DavidMihic/micromouse/hardware/extras/Micromouse_Footprint.DXF

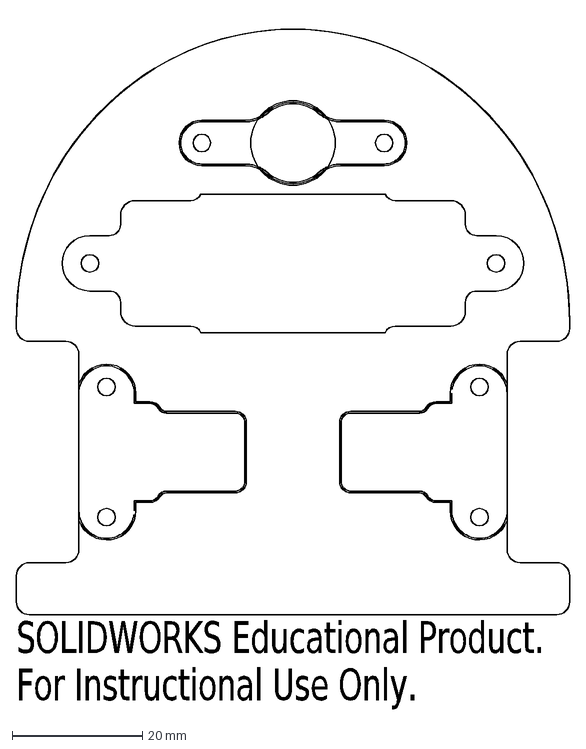
[picture p1: CAD file, 2026-04-24]
hardware/extras/Micromouse_Footprint.DXF
SOLIDWORKS Educational Product.
For Instructional Use Only.
