DavidMihic/micromouse/hardware/motors and wheels/pololu-ball-caster-with-0-375in-ball.SLDPRT

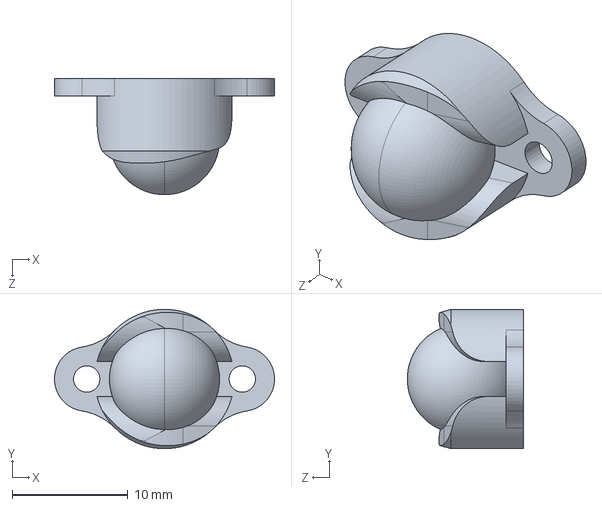
[picture p2: CAD file, 2026-04-17]
hardware/motors and wheels/pololu-ball-caster-with-0-375in-ball.SLDPRT
19.0 x 12.1 x 10.1 mm
