DavidMihic/micromouse/hardware/stl/motor_spacer.STL

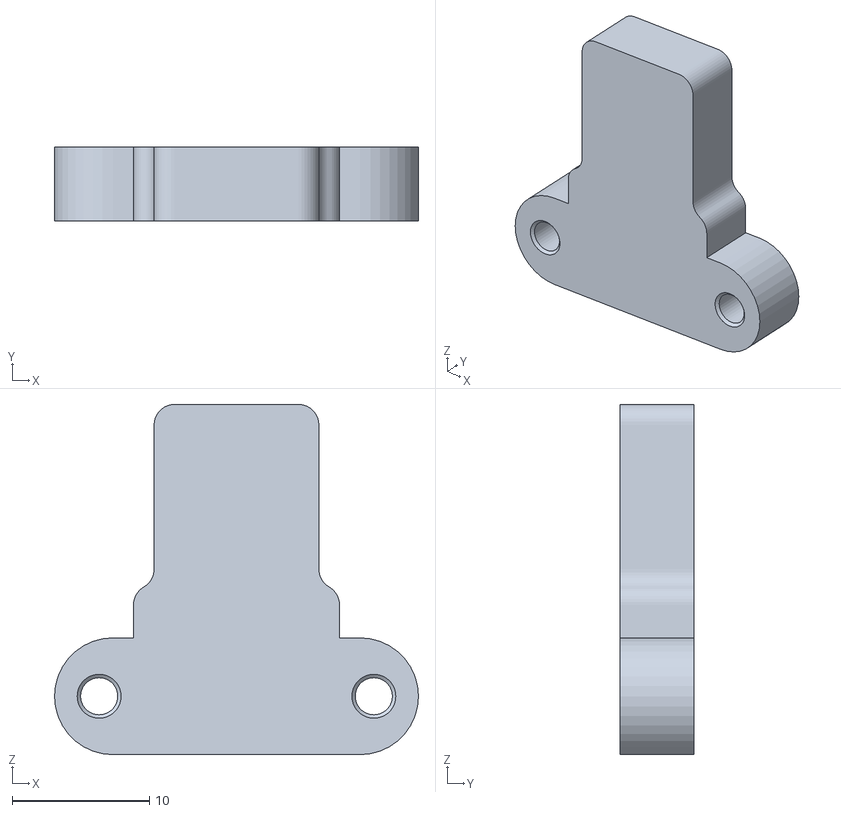
[picture p3: CAD file, 2026-04-29]
hardware/stl/motor_spacer.STL
26.5 x 5.40 x 25.5
