DavidMihic/micromouse/hardware/Visualisation assembly/Micromouse_PCB.step

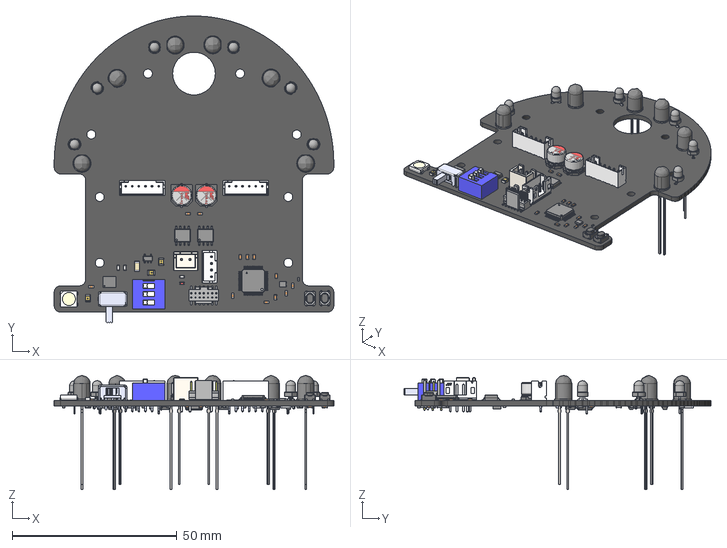
[picture p4: CAD file, 2026-05-03]
hardware/Visualisation assembly/Micromouse_PCB.step
85.0 x 93.3 x 34.7 mm
