DavidMihic/micromouse/pcb/bottom stencil/bottom_stencil.SLDPRT

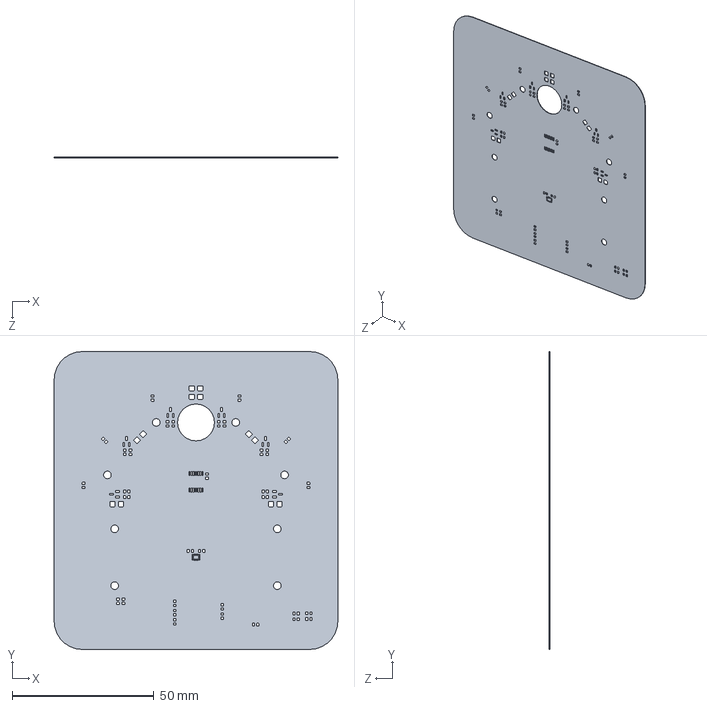
[picture p5: CAD file, 2026-05-12]
pcb/bottom stencil/bottom_stencil.SLDPRT
100.0 x 105.0 x 0.2 mm
