DavidMihic/micromouse/hardware/battery_holder.SLDPRT

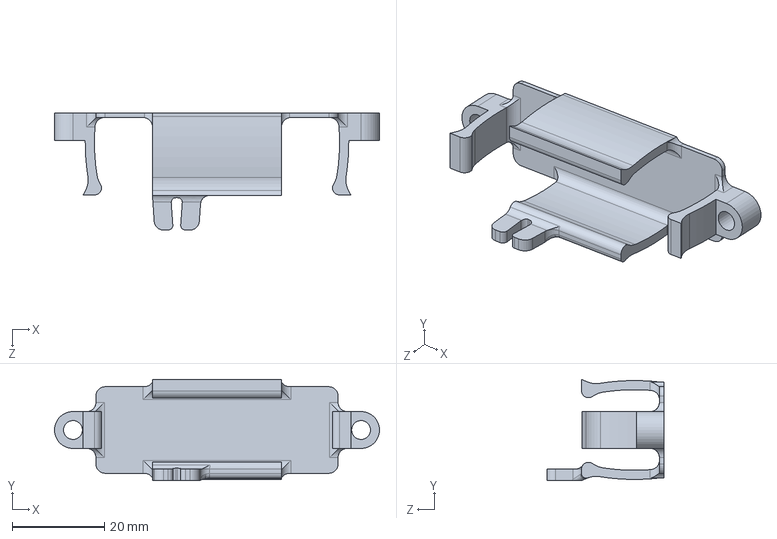
[picture p6: CAD file, 2026-04-29]
hardware/battery_holder.SLDPRT
70.5 x 22.0 x 25.4 mm
