DavidMihic/micromouse/hardware/extras/crta-logo.dxf

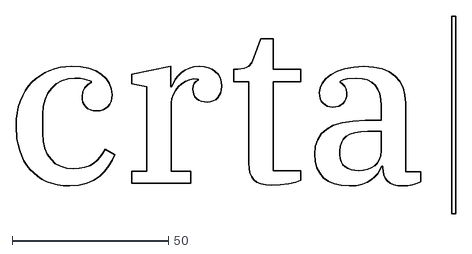
[picture p7: CAD file, 2026-04-23]
hardware/extras/crta-logo.dxf
140.7 x 63.1
