DavidMihic/micromouse/hardware/stl/bracket.STL

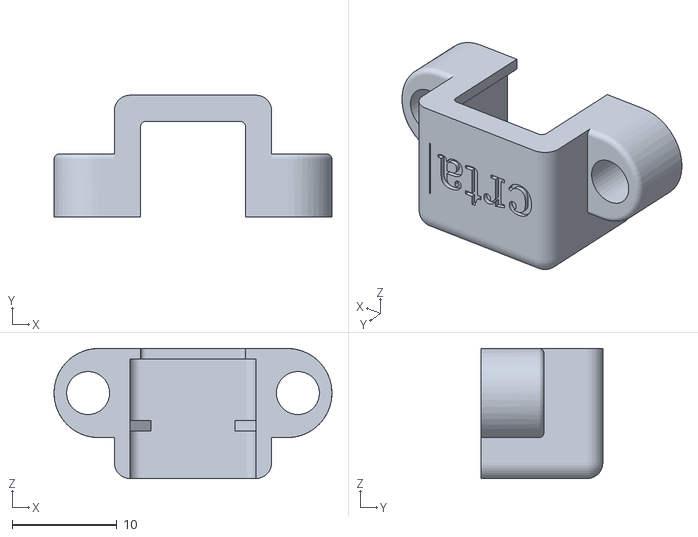
[picture p8: CAD file, 2026-04-23]
hardware/stl/bracket.STL
26.5 x 11.6 x 12.4
