DavidMihic/micromouse/hardware/PCB_concept.SLDPRT

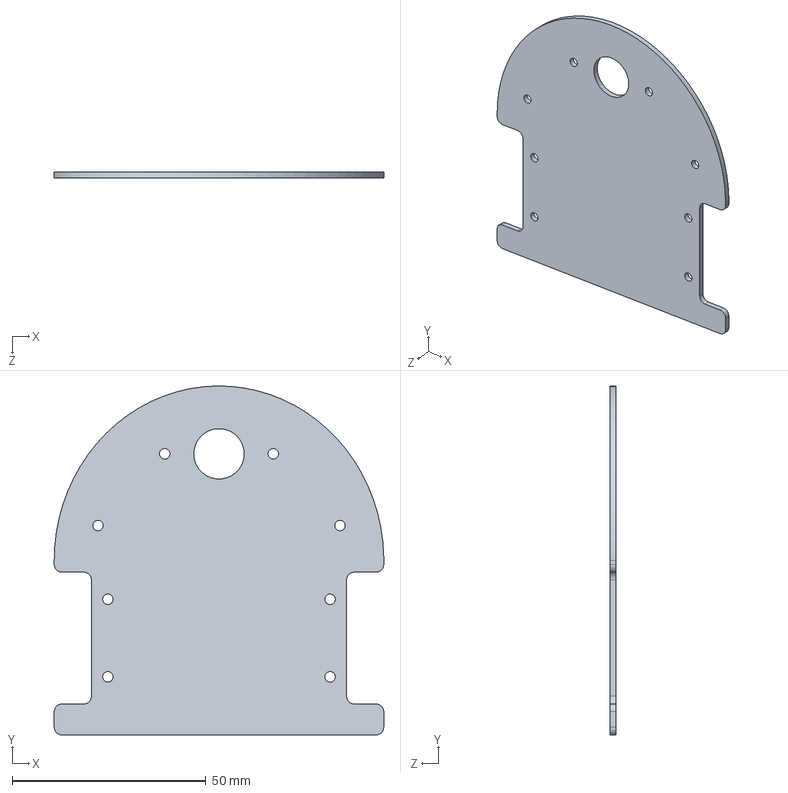
[picture p9: CAD file, 2026-04-23]
hardware/PCB_concept.SLDPRT
85.0 x 90.0 x 1.60 mm
