DavidMihic/micromouse/hardware/stl/caster_spacer.STL

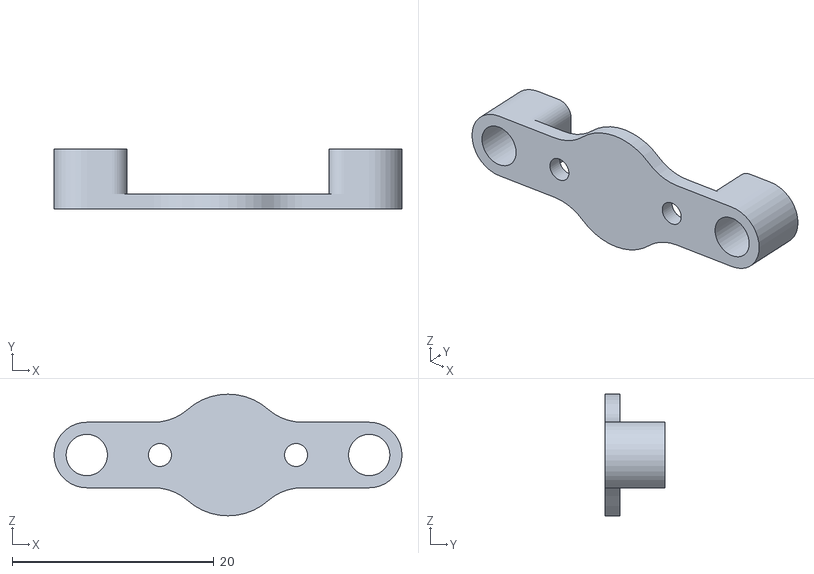
[picture p10: CAD file, 2026-04-23]
hardware/stl/caster_spacer.STL
34.5 x 5.97 x 12.1
