DavidMihic/micromouse/hardware/battery.SLDPRT

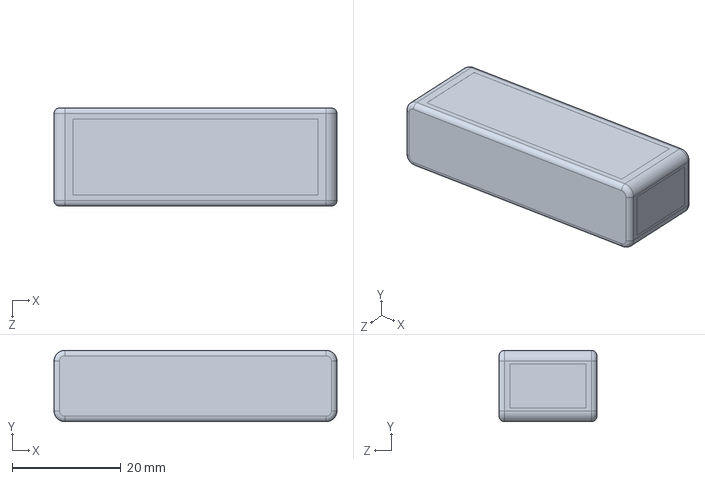
[picture p11: CAD file, 2026-04-17]
hardware/battery.SLDPRT
52.0 x 13.1 x 18.0 mm
