DavidMihic/micromouse/hardware/brackets and screws/fasteners/din912-m2.5x13.SLDPRT

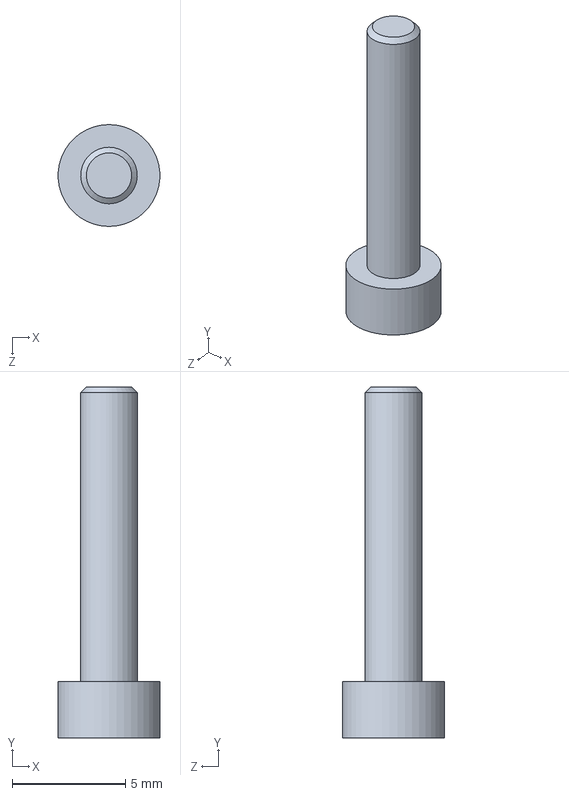
[picture p12: CAD file, 2026-04-19]
hardware/brackets and screws/fasteners/din912-m2.5x13.SLDPRT
4.49 x 15.5 x 4.50 mm
