DavidMihic/micromouse/hardware/brackets and screws/front_cover.SLDPRT

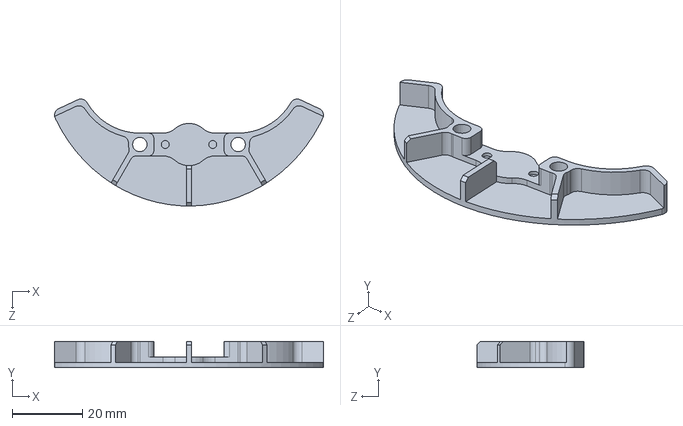
[picture p13: CAD file, 2026-05-25]
hardware/brackets and screws/front_cover.SLDPRT
76.5 x 7.47 x 30.4 mm
