DavidMihic/micromouse/hardware/motors and wheels/MotorEncoderWheel.SLDASM

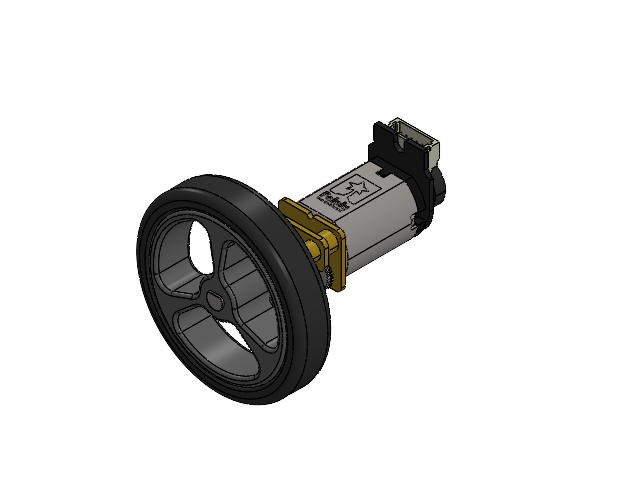
[picture p15: CAD file, 2026-04-17]
hardware/motors and wheels/MotorEncoderWheel.SLDASM
mmgm-cb-ext-shaft.step
magnetic-encoder-with-side-entry-connector-for-micro-metal-gearmotors.step
magnetic-encoder-disc-for-micro-metal-gearmotors.step
pololu-wheel-32x7mm-black.step
