DavidMihic/micromouse/hardware/Visualisation assembly/Micromouse_Assembly_real.SLDASM

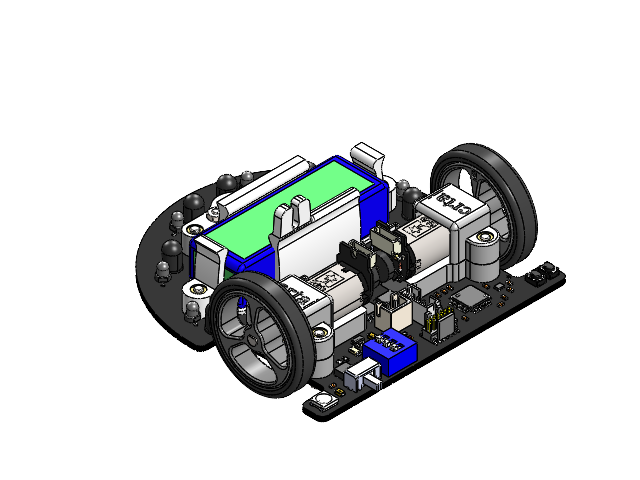
[picture p16: CAD file, 2026-05-03]
hardware/Visualisation assembly/Micromouse_Assembly_real.SLDASM
mmgm-cb-ext-shaft.step x 2
magnetic-encoder-with-side-entry-connector-for-micro-metal-gearmotors.step x 2
magnetic-encoder-disc-for-micro-metal-gearmotors.step x 2
pololu-wheel-32x7mm-black.step x 2
pololu-ball-caster-with-0-375in-ball
bracket x 2
battery
motor_spacer x 2
caster_spacer
battery_holder
M2.5 Insert x 8
din912-m2.5x13 x 4
din912-m2.5x8 x 4
din7380-m2x5 x 2
din934-m2 x 2
Micromouse_PCB
