DavidMihic/micromouse/(list of files, cad)

Other CAD files:
pcb/bottom stencil/bottom solder.DWG
hardware/stl/PCB.STL
hardware/Visualisation assembly/Micromouse_PCB.SLDPRT
hardware/brackets and screws/bracket.SLDPRT
hardware/brackets and screws/caster_spacer.SLDPRT
hardware/brackets and screws/fasteners/M2.5 Insert.SLDPRT
hardware/brackets and screws/fasteners/din7380-m2x5.SLDPRT
hardware/brackets and screws/fasteners/din912-m2.5x8.SLDPRT
hardware/brackets and screws/fasteners/din912-m2x5.SLDPRT
hardware/brackets and screws/fasteners/din934-m2.SLDPRT
hardware/brackets and screws/micro-metal-gearmotor-bracket.SLDPRT
hardware/brackets and screws/motor_spacer.SLDPRT
hardware/stl/battery_holder.STL
