DavidMihic/micromouse/(list of files, drawings)

Other design files:
pcb/Micromouse.PrjPcb
pcb/Micromouse_PCB_Final.PcbDoc
pcb/Schematic-Lib-PhilsLab.SchLib
pcb/Shema.SchDoc
