DavidMihic/micromouse/software/software.ioc

Mcu.UserName=STM32G474CETx
PA0.GPIO_Label=E_A_L
PA0.Signal=S_TIM2_CH1
PA1.GPIO_Label=E_B_L
PA1.Signal=S_TIM2_CH2
PA10.GPIO_Label=IN_1_R
PA10.Signal=S_TIM1_CH3
PA11.GPIO_Label=IN_2_R
PA11.Signal=S_TIM1_CH4
PA12.GPIO_Label=E_B_R
PA12.Signal=S_TIM4_CH2
PA13.Signal=SYS_JTMS-SWDIO
PA14.Signal=SYS_JTCK-SWCLK
PA15.GPIO_Label=LED_IN
PA15.Signal=S_TIM8_CH1
PA2.Signal=USART2_TX
PA3.Signal=USART2_RX
PA4.GPIO_Label=IMU_CS
PA4.Signal=GPIO_Output
PA5.GPIO_Label=IMU_SCK
PA5.Signal=SPI1_SCK
PA6.GPIO_Label=IMU_MISO
PA6.Signal=SPI1_MISO
PA7.GPIO_Label=IMU_MOSI
PA7.Signal=SPI1_MOSI
PA8.GPIO_Label=IN_1_L
PA8.Signal=S_TIM1_CH1
PA9.GPIO_Label=IN_2_L
PA9.Signal=S_TIM1_CH2
PB0.GPIO_Label=IMU_INT2
PB0.Signal=GPXTI0
PB1.GPIO_Label=IR_REC_2
PB1.Signal=ADC1_IN12
PB10.GPIO_Label=DMUX_EN
PB10.Signal=GPIO_Output
PB11.GPIO_Label=IR_REC_3
PB11.Signal=ADC1_IN14
PB12.GPIO_Label=IR_REC_4
PB12.Signal=ADC1_IN11
PB13.GPIO_Label=BTN_2
PB13.Signal=GPXTI13
PB14.GPIO_Label=IR_REC_5
PB14.Signal=ADC1_IN5
PB15.GPIO_Label=IR_REC_6
PB15.Signal=ADC2_IN15
PB2.GPIO_Label=IR_REC_1
PB2.Signal=ADC2_IN12
PB3.Signal=SYS_JTDO-SWO
PB4.GPIO_Label=BTN_1
PB4.Signal=GPXTI4
PB5.GPIO_Label=DMUX_A0
PB5.Signal=GPIO_Output
PB6.GPIO_Label=E_A_R
PB6.Signal=S_TIM4_CH1
PB7.GPIO_Label=DMUX_A1
PB7.Signal=GPIO_Output
PB9.GPIO_Label=DMUX_A2
PB9.Signal=GPIO_Output
PC13.GPIO_Label=DIP_1
PC13.Signal=GPIO_Input
PC14-OSC32_IN.GPIO_Label=DIP_2
PC14-OSC32_IN.Signal=GPIO_Input
PC15-OSC32_OUT.GPIO_Label=DIP_3
PC15-OSC32_OUT.Signal=GPIO_Input
PF0-OSC_IN.Signal=RCC_OSC_IN
PF1-OSC_OUT.Signal=RCC_OSC_OUT
