DavidMihic/micromouse/software/Core/Inc/main.h

#define DIP_1_Pin GPIO_PIN_13
#define DIP_1_GPIO_Port GPIOC
#define DIP_2_Pin GPIO_PIN_14
#define DIP_2_GPIO_Port GPIOC
#define DIP_3_Pin GPIO_PIN_15
#define DIP_3_GPIO_Port GPIOC
#define E_A_L_Pin GPIO_PIN_0
#define E_A_L_GPIO_Port GPIOA
#define E_B_L_Pin GPIO_PIN_1
#define E_B_L_GPIO_Port GPIOA
#define IMU_CS_Pin GPIO_PIN_4
#define IMU_CS_GPIO_Port GPIOA
#define IMU_SCK_Pin GPIO_PIN_5
#define IMU_SCK_GPIO_Port GPIOA
#define IMU_MISO_Pin GPIO_PIN_6
#define IMU_MISO_GPIO_Port GPIOA
#define IMU_MOSI_Pin GPIO_PIN_7
#define IMU_MOSI_GPIO_Port GPIOA
#define IMU_INT2_Pin GPIO_PIN_0
#define IMU_INT2_GPIO_Port GPIOB
#define IMU_INT2_EXTI_IRQn EXTI0_IRQn
#define IR_REC_2_Pin GPIO_PIN_1
#define IR_REC_2_GPIO_Port GPIOB
#define IR_REC_1_Pin GPIO_PIN_2
#define IR_REC_1_GPIO_Port GPIOB
#define DMUX_EN_Pin GPIO_PIN_10
#define DMUX_EN_GPIO_Port GPIOB
#define IR_REC_3_Pin GPIO_PIN_11
#define IR_REC_3_GPIO_Port GPIOB
#define IR_REC_4_Pin GPIO_PIN_12
#define IR_REC_4_GPIO_Port GPIOB
#define BTN_2_Pin GPIO_PIN_13
#define BTN_2_GPIO_Port GPIOB
#define BTN_2_EXTI_IRQn EXTI15_10_IRQn
#define IR_REC_5_Pin GPIO_PIN_14
#define IR_REC_5_GPIO_Port GPIOB
#define IR_REC_6_Pin GPIO_PIN_15
#define IR_REC_6_GPIO_Port GPIOB
#define IN_1_L_Pin GPIO_PIN_8
#define IN_1_L_GPIO_Port GPIOA
#define IN_2_L_Pin GPIO_PIN_9
#define IN_2_L_GPIO_Port GPIOA
#define IN_1_R_Pin GPIO_PIN_10
#define IN_1_R_GPIO_Port GPIOA
#define IN_2_R_Pin GPIO_PIN_11
#define IN_2_R_GPIO_Port GPIOA
#define E_B_R_Pin GPIO_PIN_12
#define E_B_R_GPIO_Port GPIOA
#define LED_IN_Pin GPIO_PIN_15
#define LED_IN_GPIO_Port GPIOA
#define BTN_1_Pin GPIO_PIN_4
#define BTN_1_GPIO_Port GPIOB
#define BTN_1_EXTI_IRQn EXTI4_IRQn
#define DMUX_A0_Pin GPIO_PIN_5
#define DMUX_A0_GPIO_Port GPIOB
#define E_A_R_Pin GPIO_PIN_6
#define E_A_R_GPIO_Port GPIOB
#define DMUX_A1_Pin GPIO_PIN_7
#define DMUX_A1_GPIO_Port GPIOB
#define DMUX_A2_Pin GPIO_PIN_9
#define DMUX_A2_GPIO_Port GPIOB
