DavidMihic/micromouse/(commit log)

2026-04-13 fixed folder structure, removed .gitkeep
    [Bracketi_vijci.SLDASM, MicroMouse-General_Assembly.SLDASM, MicroMouse-pogon.SLDASM, MotorEncoderWheel.SLDASM, PCB-concept1.SLDPRT, micro-metal-gearmotor-bracket.SLDPRT, pololu-ball-caster-with-0-375in-ball.SLDPRT]
2026-04-13 uploaded schematic and altium files, removed .gitkeep
    [Micromouse.PrjPcb, Schematic-Lib-PhilsLab.SchLib, Shema.SchDoc]
2026-04-14 Finished schematics
    [Shema.SchDoc]
2026-04-14 test git
    [Shema.SchDoc]
2026-04-14 test git try 2
    [Shema.SchDoc]
2026-04-14 test git 3
    [Shema.SchDoc]
2026-04-14 ERC check
    [Shema.SchDoc]
2026-04-14 Started working on PCB
    [Micromouse.PrjPcb, Micromouse_PCB.PcbDoc]
2026-04-14 added PCB
2026-04-14 Placed some components on PCB
2026-04-14 test commit
    [Micromouse_PCB.PcbDoc]
2026-04-14 Changed the PCB dimension to 90x100 mm, added small fixes to sketch constraints and global variables.
    [MicroMouse-pogon.SLDASM]
2026-04-14 Made small changes to constraints and global variables.
    [Bracketi_vijci.SLDASM]
2026-04-14 Changed PCB dimensions to 90xx100 mm, added small fixes to constraints
    [MicroMouse-General_Assembly.SLDASM, PCB-concept1.SLDPRT]
2026-04-14 first pcb prototype
    [Micromouse_PCB.PcbDoc, Shema.SchDoc]
2026-04-15 Removed PCB History
2026-04-16 made custom bracket prototype
    [bracket.SLDPRT]
2026-04-17 removed hole offset, added fillet
    [bracket.SLDPRT]
2026-04-17 finalised bracket, added basic batery model and updated assembly
    [MicroMouse-General_Assembly.SLDASM, battery.SLDPRT, bracket.SLDPRT]
2026-04-17 updated assembly structure, made spacers for motors and caster
    [Bracketi_vijci.SLDASM, MicroMouse-General_Assembly.SLDASM, MicroMouse-pogon.SLDASM, Micromouse_Assembly.SLDASM, MotorEncoderWheel.SLDASM, PCB-concept1.SLDPRT, battery.SLDPRT, bracket.SLDPRT]
2026-04-19 fixed caster spacer hole spacing
    [Micromouse_Assembly.SLDASM, caster_spacer.SLDPRT]
2026-04-19 added pcb keepout footprint
    [Micromouse_Assembly.SLDASM]
2026-04-19 added inserts and fasteners
    [M2.5 Insert.SLDPRT, Micromouse_Assembly.SLDASM, din7380-m2x5.SLDPRT, din912-m2.5x13.SLDPRT, din912-m2.5x8.SLDPRT, din912-m2x5.SLDPRT, din934-m2.SLDPRT]
2026-04-19 added battery holder
    [battery_holder.SLDPRT]
2026-04-19 added battery holder with corresponding mates, fasteners and inserts in the general assembly
    [Micromouse_Assembly.SLDASM, PCB-concept1.SLDPRT, battery_holder.SLDPRT]
2026-04-20 fixed pcb hole diameters, made keep-out footprint for pcb
    [Micromouse_Assembly.SLDASM, Micromouse_Footprint.DXF, PCB-concept1.SLDPRT, battery_holder.SLDPRT]
2026-04-20 started working on new pcb
    [Micromouse.PrjPcb, Micromouse_PCB_Final.PcbDoc, Shema.SchDoc]
2026-04-22 added stl files for 3d printing
    [PCB.STL, battery_holder.STL, bracket.STL, caster_spacer.STL, motor_spacer.STL]
2026-04-22 fixed pcb hole sizes, added crta logo to brackets, moved footprint (will be changed)
    [Micromouse_Assembly.SLDASM, Micromouse_Footprint.DXF, PCB-concept1.SLDPRT, bracket.SLDPRT, crta-logo.dxf]
2026-04-22 made 'crta' text deeper, updated stl files
    [Micromouse_Assembly.SLDASM, PCB.STL, bracket.SLDPRT, bracket.STL]
2026-04-23 Added tthe updated design of the battery holder
    [battery_holder.SLDPRT]
2026-04-24 added a new configuration for easier footprint exporting, exported new footprint
    [Micromouse_Assembly.SLDASM, Micromouse_Footprint.DXF]
2026-04-24 changed pcb to use new footprint
    [Micromouse.PrjPcb, Micromouse_PCB_Final.PcbDoc, Shema.SchDoc]
2026-04-25 Update Micromouse_PCB_Final.PcbDoc
    Added components to final PCB
    [Micromouse_PCB_Final.PcbDoc]
2026-04-26 added altium extra files to gitignore, added layer stackup and design rules to pcb
    [Micromouse_PCB_Final.PcbDoc]
2026-04-27 placed components on pcb
    [Micromouse.PrjPcb, Micromouse_PCB_Final.PcbDoc]
2026-04-28 started routing pcb
    [Micromouse_PCB_Final.PcbDoc]
2026-04-28 did more routing, almost done
    [Micromouse_PCB_Final.PcbDoc]
2026-04-29 updated battery holder cable clip, enlarged screw holes on motor spacer
    [Micromouse_Assembly.SLDASM, battery_holder.SLDPRT, battery_holder.STL, motor_spacer.SLDPRT, motor_spacer.STL]
2026-05-01 Started routing power lines
    [Micromouse_PCB_Final.PcbDoc, Shema.SchDoc]
2026-05-02 updated resistor and capacitor values from x.yZR to xZyR
    [Micromouse_PCB_Final.PcbDoc, Shema.SchDoc]
2026-05-03 Added a new assemblly with all electronic components mounted on the pcb, in order to visualise the final micromouse design.
    [Micromouse_Assembly_real.SLDASM, Micromouse_PCB_Real.SLDPRT]
2026-05-03 finished pcb routing
    [Micromouse_PCB_Final.PcbDoc, Shema.SchDoc]
2026-05-03 removed old pcb file, moved some designators around on new one
    [Micromouse_PCB.PcbDoc, Micromouse_PCB_Final.PcbDoc]
2026-05-03 enforced naming convention, cleaned up folder structure, updated mock assembly with new pcb model
    [M2.5 Insert.SLDPRT, Micromouse_Assembly.SLDASM, Micromouse_Assembly_real.SLDASM, Micromouse_PCB.SLDPRT, Micromouse_PCB.step, Micromouse_PCB_Real.SLDPRT, MotorEncoderWheel.SLDASM, PCB_concept.SLDPRT]
2026-05-04 generated gerbers, sent to production
    [Micromouse.PrjPcb, Micromouse_PCB_Final.PcbDoc]
2026-05-12 made a stencil for the bottom side solder paste
    [bottom solder.DWG, bottom_stencil.SLDPRT]
2026-05-24 created stm32 pin configuration .ioc file
2026-05-25 testing stm32 peripherals
2026-05-25 created new caster spacer with blinders for LEDs
    [front_cover.SLDPRT]
2026-05-26 modified: software/.cproject modified: software/.mxproject modified: software/.settings/language.settings.xml modified: software/Core/Src/main.c modified: software/Core/Src/stm32g4xx_hal_msp.c modifi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
2026-05-26 changed motor controller parameters
2026-05-27 created motor and encoder library
2026-05-27 edited .ioc config
    [software Debug.cfg]
2026-05-27 edited motor library
2026-05-27 created velocity_pi.h
2026-05-27 fixed startup folder missing
    [software Debug.cfg]
2026-05-27 tested motor and encoder libraries
2026-05-27 added imu library
2026-05-27 created PI velocity controller library
2026-05-28 added button library
2026-05-28 added PI regulator to a seperate timer
2026-05-28 created IR Sensors library
2026-05-28 moved imu updating to timer 3 instead of main loop
2026-05-28 finished IMU
2026-05-28 tested IR sensor library
2026-05-29 improved IMU code
2026-05-30 fixed braces warning, fixed wrong function call
    [motion.c]
